KGL-Gr/my_Thesis/assets/Fprob_THP_timeseries.png

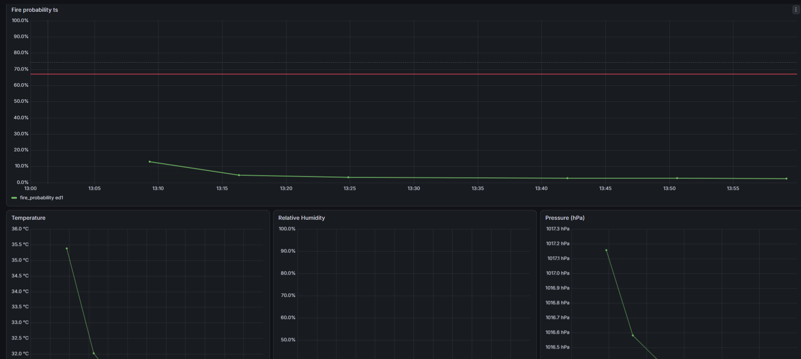
assets/Fprob_THP_timeseries.png
