KGL-Gr/my_Thesis/assets/Grafana_map.jpg

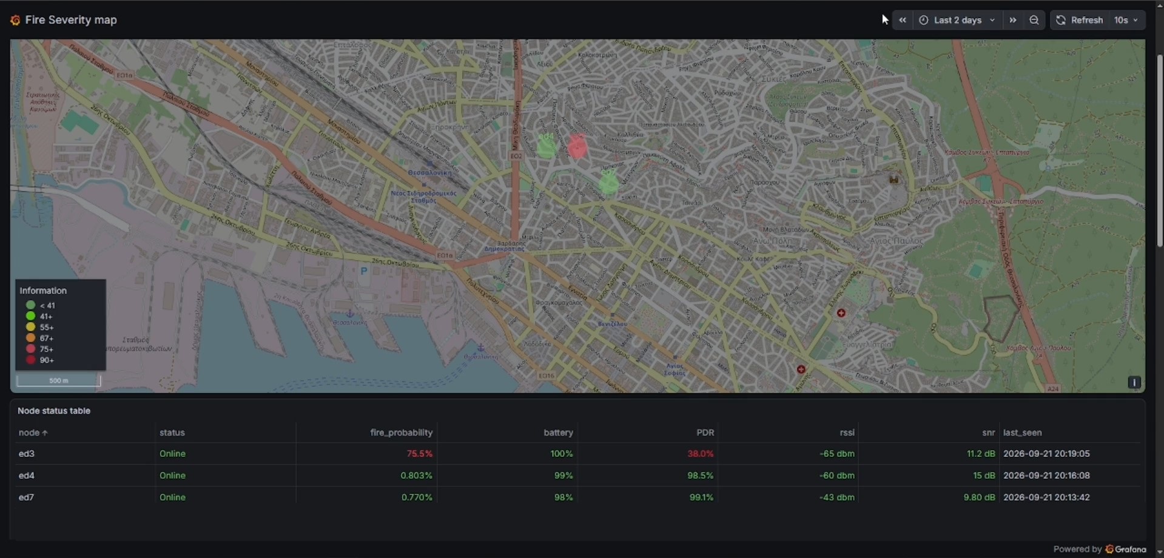
assets/Grafana_map.jpg
