KGL-Gr/my_Thesis/assets/IMG_20260905_001206.jpg

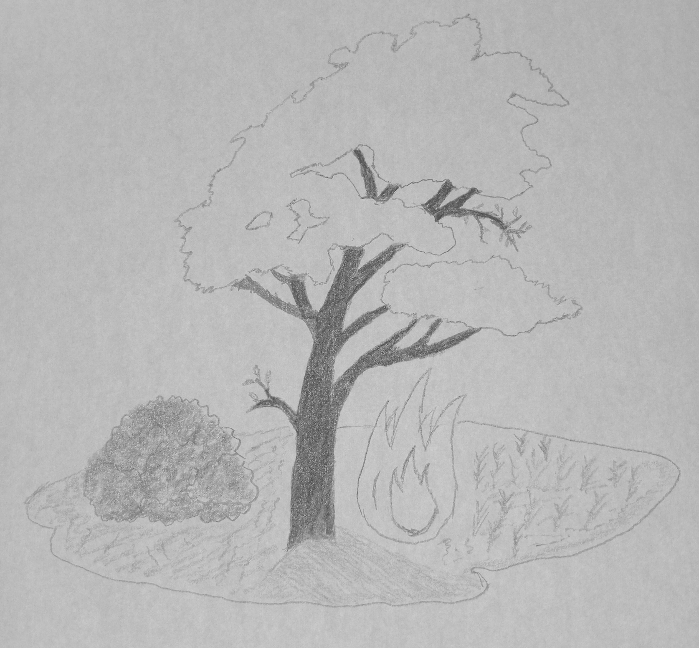
assets/IMG_20260905_001206.jpg
