KGL-Gr/my_Thesis/assets/PCB3D_view.jpg

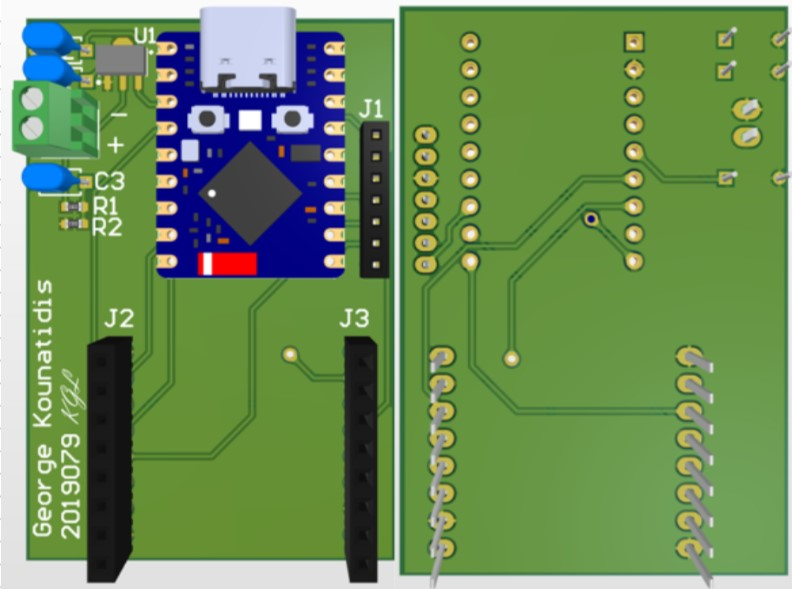
assets/PCB3D_view.jpg
