KGL-Gr/my_Thesis/assets/pcb_back.jpg

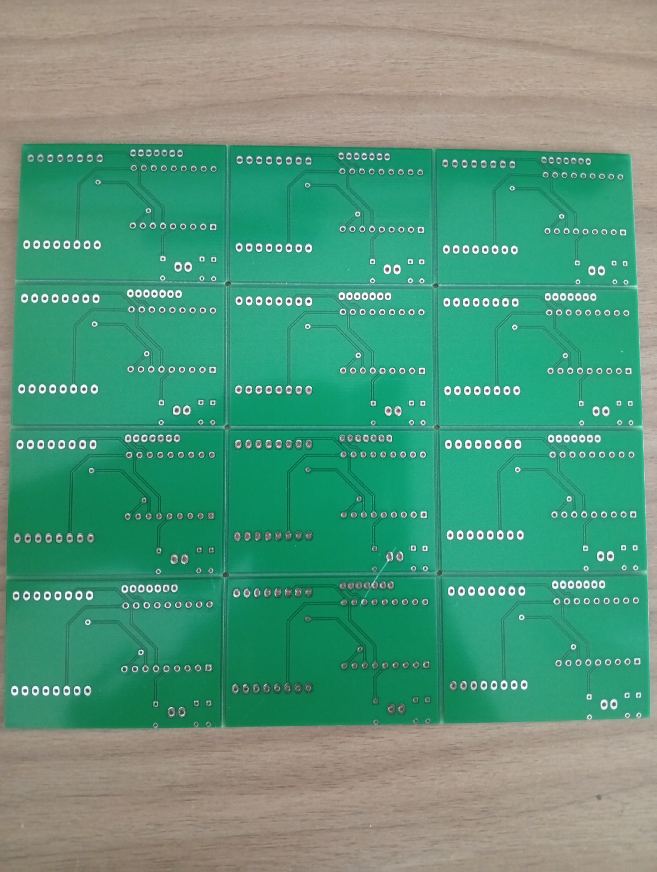
assets/pcb_back.jpg
