KGL-Gr/my_Thesis/assets/pcb_front.jpg

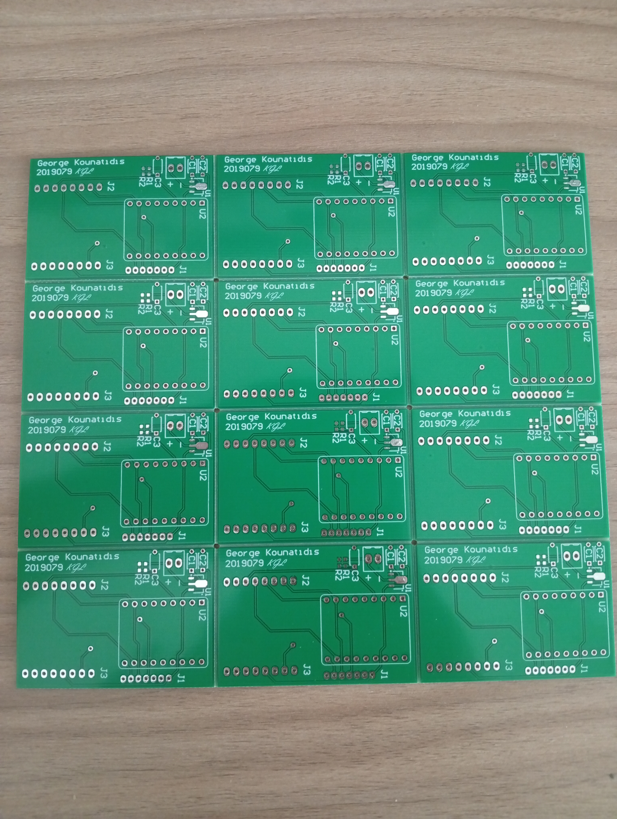
assets/pcb_front.jpg
