KGL-Gr/my_Thesis/assets/pcb_layers.jpg

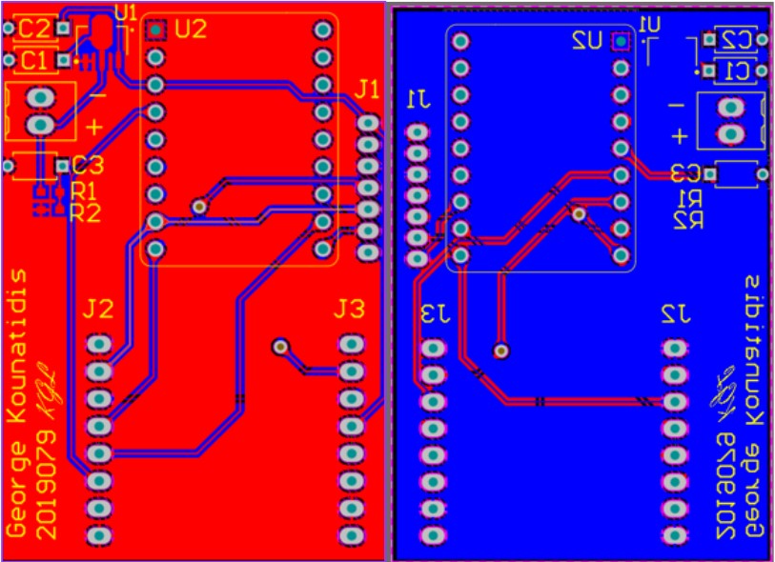
assets/pcb_layers.jpg
