KGL-Gr/my_Thesis/assets/schematic.jpg

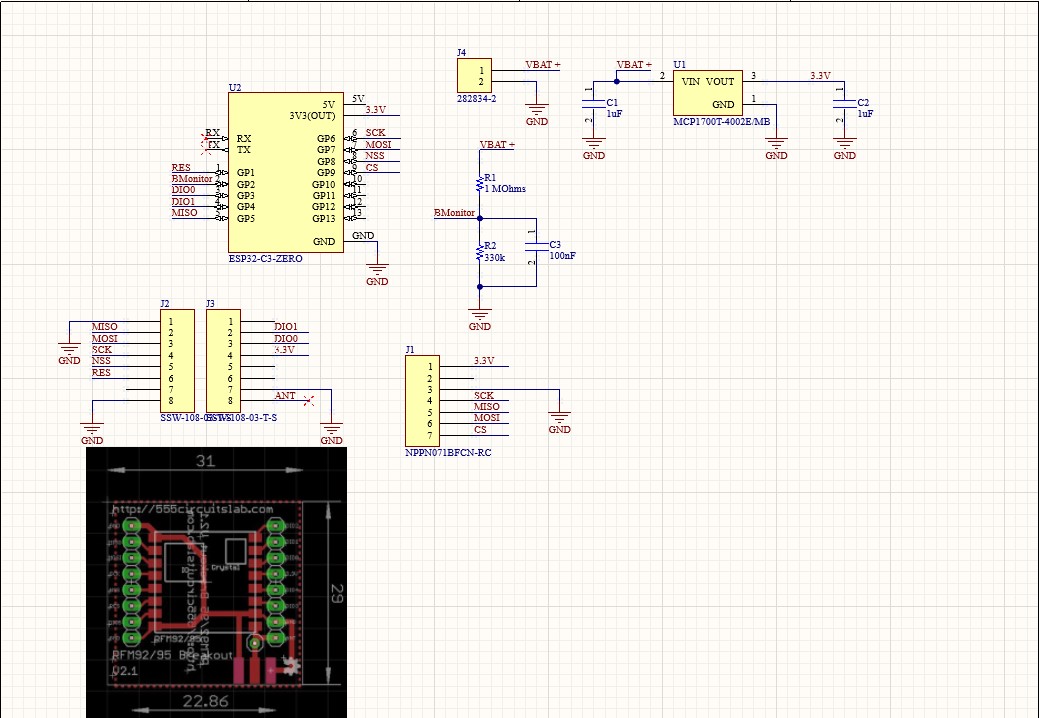
assets/schematic.jpg
