KGL-Gr/my_Thesis/(commit log)

2026-08-12 Firmware of end device
2026-08-29 Update ED1_Final_Firmare_1_3b_pcb.ino
    Fixed sleep related issue
    [ED1_Final_Firmare_1_3b_pcb.ino]
